jakplugg/Typhoon/README.md

# Typhoon
Clouds variant

BOM coming shortly!
