jakplugg/Typhoon/panel.pdf

## T Y P H O O N

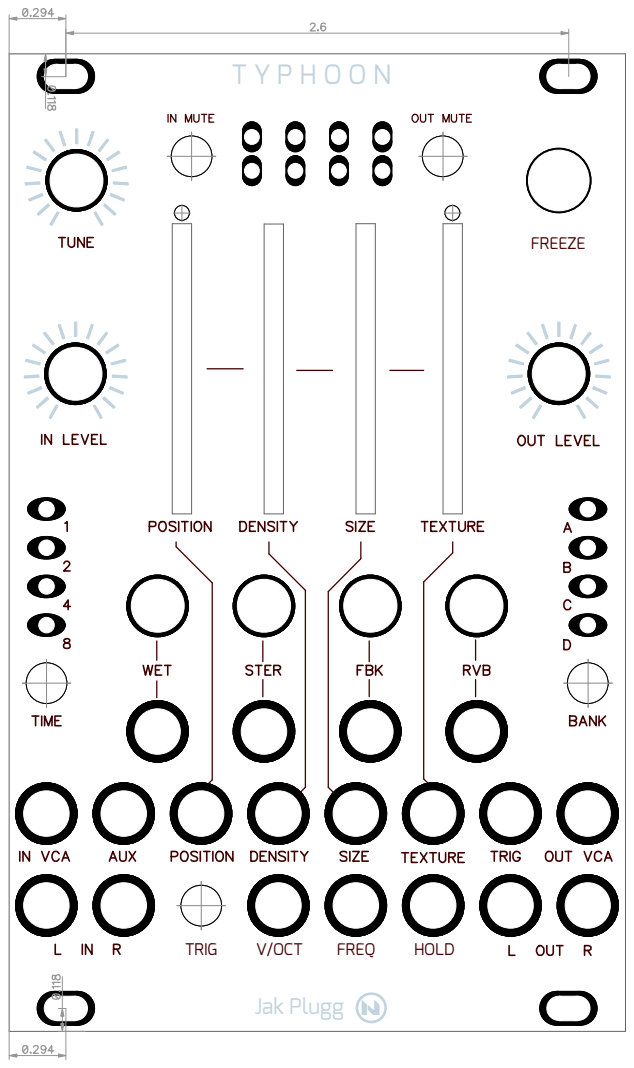
[picture p1: page 1]
Jak Plugg; TRIG; HOLD V/OCT; FREQ; FREEZE
