jakplugg/Typhoon/(list of files, drawings)

Other design files:
typhoon.dch
typhoon.dip
typhoon_panel.dip
