jakplugg/Typhoon/(threads)

Thread 1 (2019-11-26):

Pachinko

gregbabos, 2019-11-26:
Hi! I'm a hobbyist who would like to make my own Pachinko, but I can't seem to find the repository for the open-source code. I noticed it's for sale at Michigan Synth Works, so I imagine the code is open-sourced somewhere. Thanks for your time!

gregbabos, 2019-11-26:
My email address is gregbabos@gmail.com if that is preferred.

jakplugg, 2019-11-26:
Sorry it is taking a while, Now i am just waiting for panels to come
in for test fit.

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

gregbabos, 2019-11-26:
Ah, I thought it had been established that the panel fits since Michigan Synth Works has a picture of a finished Pachinko up

gregbabos, 2019-11-26:
Forgive my ignorance since I'm quite new to this, but are you affiliated with Michigan Synth Works? I'm wondering how they got the design if hasn't been open-sourced yet.

jakplugg, 2019-11-27:
He makes aluminum panels, this is for the pcbpanel. i'm just being
careful i don't release something which does not work properly!

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

jakplugg, 2019-11-27:
He does the test builds for my designs, if i did it myself things
would be much slower.

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

gregbabos, 2019-11-29:
Oh okay, thank you for the clarification and your work on open source!

Pipstapee, 2019-12-20:
Any word on the BOM, when is it due to be uploaded?

Thread 2 (2019-12-17):

Panel

TotalRefusal, 2019-12-17:
Hi! Not sure, but "TIME" and "BANK" seems to be wrong way, either on panel, or on pcb :) Cheers!

TotalRefusal, 2019-12-19:
>
>
> Hi! Not sure, but "TIME" and "BANK" seems to be wrong way, either on panel, or on pcb :) Cheers!

Took a look @schematics - seems the panel to be wrong way. BANK is left and TIME is right :)

dlavila, 2020-09-11:
why is this closed if the panel was not fixed?

Closed 2019-12-19.

Thread 3 (2019-12-20):

BOM and firmware?

Pipstapee, 2019-12-20:
Any news on the BOM for the Typhoon (Supercell/Monsoon/Clouds) pcb on the pusherman website. Also, firmware, would it be released as a HEX?

TotalRefusal, 2019-12-20:
>
>
> Any news on the BOM for the Typhoon (Supercell/Monsoon/Clouds) pcb on the pusherman website. Also, firmware, would it be released as a HEX?

Wow, Pusherman did the wrong panel design. Time & Bank is labeled wrong way, at least if you follow pcb & schematics.

Pipstapee, 2019-12-20:
> > Any news on the BOM for the Typhoon (Supercell/Monsoon/Clouds) pcb on the pusherman website. Also, firmware, would it be released as a HEX?
>
> Wow, Pusherman did the wrong panel design. Time & Bank is labeled wrong way, at least if you follow pcb & schematics.

It's a good job I've not ordered any yet. Woops...I'll let him know, thanks for pointing that out.

forestcaver, 2020-01-11:
You can build the fw yourself pretty easily - just follow the links in the microcell github to the superparasites fw. BOM can be exported from diptrace. Note that the export says it uses tle2172 (this is incorrect - it should be tlv2172 vssop package)

Tnunnery, 2020-02-12:
What is the value of the 30mm slider pots? Did I miss it somewhere?

jakplugg, 2020-02-12:
They are A10k, non detented. bourns PTL or compatible.

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

epijdemie, 2020-02-24:
@jakplugg what are the voltage ratings of the capacitors in use for Typhoon?

jakplugg, 2020-02-24:
Minimum 16v, but the higher the better.

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

epijdemie, 2020-03-03:
@jakplugg regarding firmware: can i upload the regular clouds via mutable vagrant and SWD (or even STLink util) so i have a bootloader and then user the superparasites.wav to upload the firmware? i can not get https://github.com/patrickdowling/superparasites compile in mutable's vagrant and i am too noob to configure it :/

forestcaver, 2020-03-03:
No - cant upload regular clouds fw to typhoon
To compile the superparasites - follow the instructions in the readme - see my comment above - you need to install a different arm toolchain into the mutable dev environment

epijdemie, 2020-03-03:
> No - cant upload regular clouds fw to typhoon
> To compile the superparasites - follow the instructions in the readme - see my comment above - you need to install a different arm toolchain into the mutable dev environment

damn, i am too stupid for linux stuff. i am using mutables vagrant on windows and literally copy/paste every command line from the mutable manual. is there maybe a vagrant around that has this toolchain installed? or a detailed tutorial for noobs like myself? :(

forestcaver, 2020-03-03:
I dont know if anyone has setup the vagrantbox scripts for this box. It wouldnt be hard to do...
I dont know of any detailed tutorials for setting up this exact configuration...
You could just upload a compiled bootloader and main fw hex with ST-Link utility....

epijdemie, 2020-03-03:
> I dont know if anyone has setup the vagrantbox scripts for this box. It wouldnt be hard to do...
> I dont know of any detailed tutorials for setting up this exact configuration...
> You could just upload a compiled bootloader and main fw hex with ST-Link utility....

i managed to compile the supercell.hex within the MI vagrant with the src and toolchain @patrickdowling listed in the superparasites github.. however it fails to compile the bootloader, and without it the upload command wount work and i guess uploading the hex without the bootloader wount do any good. and i also guess i cannot just take the clouds bootloader. so if anyone could link a pre-compiled supercell_bootloader_combo.hex i would be very thankful :)

TotalRefusal, 2020-03-03:
I took the Clouds bootloader & it works like a charm :)

epijdemie, 2020-03-03:
i just got the bootloader to compile by NOT taking the stmlib from superparasites, but MI original one. having a combo file now and very curios if its gonna work :) (build not finished yet)

TotalRefusal, 2020-03-03:
.... also use microcell.hex and guess what? It works like a charm :) Beside the slider leds (with opamps) it is pretty much the same hardware. Firmware does not care if there is a 10k pot or a 10k slider :)

frekkia, 2020-05-06:
What dielectrics do ceramic capacitors use?

jakplugg, 2020-05-07:
usually only C0G/NP0 capacitors are noted, default is X7R or X5R.

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

frekkia, 2020-05-07:
> usually only C0G/NP0 capacitors are noted, default is X7R or X5R.
> […](#)

I have seen that the white pushbutton uses a minimum voltage of 3.5v and I would like to change it with a green one, but it has a maximum voltage of 2.5v, is it okay?

jakplugg, 2020-05-08:
The circuit is designed with no LED resistor (because of the high
voltage drop of the white LED) theoretically there should be a 43 ohm
resistor in series if the LED only has 2.5 Voltage drop. it *MAY* be
OK, but if it is not, it will destroy that output on the STM.

i should add the resistors back in, they were removed in the microcell
which typhoon was adapted from, and i did not even notice.

On 5/7/20, frekkia <notifications@github.com> wrote:
>> usually only C0G/NP0 capacitors are noted, default is X7R or X5R.

>> […](#)

>

> I have seen that the white pushbutton uses a minimum voltage of 3.5v and I
> would like to change it with a green one, but it has a maximum voltage of
> 2.5v, is it okay?

>

> --

> You are receiving this because you were mentioned.

> Reply to this email directly or view it on GitHub:

> https://github.com/jakplugg/Typhoon/issues/3#issuecomment-625529699

frekkia, 2020-05-08:
In fact I was comparing the pcb of clouds and that of typhoon, clouds adds two 68 ohm resistors in series, I could cut the track and add them manually in typhoon, what do you say?

frekkia, 2020-05-08:
> The circuit is designed with no LED resistor (because of the high voltage drop of the white LED) theoretically there should be a 43 ohm resistor in series if the LED only has 2.5 Voltage drop. it *MAY* be OK, but if it is not, it will destroy that output on the STM. i should add the resistors back in, they were removed in the microcell which typhoon was adapted from, and i did not even notice.
> […](#)

In fact I was comparing the pcb of clouds and that of typhoon, clouds adds two 68 ohm resistors in series, I could cut the track and add them manually in typhoon, what do you say?

TotalRefusal, 2020-05-08:
I have a yellow LED running, with no problems so far :)

jakplugg, 2020-05-12:
no reason you can't cut the trace and add a resistor if you are comfortable doing so.

frekkia, 2020-05-24:
LM4040 is grade C okay?

Pipstapee, 2020-05-25:
LM4040 the grade C or B doesn't make a difference right?
You buying from Mouser, B or C will be ok.

Faye108, 2020-06-03:
@jakplugg What are suggested Ferrite beads for FB1 and FB2 ? I have some in stock that I had used for other Mutable clones. Can I use one of these? If so, which one?
Mouser no. 710-742792693
Mouser no. 710-742792642
Mouser no. 710-742792664

Another question regarding R28 and R36 : Both 49.9k placed between Aref-2.5 and U9 (SSI2146) : Mouser canceled it in my order. Can they be replaced by another value? A.e. 47k or something in the 51k range maybe?

thank you!

SatsumaAudio, 2020-07-27:
Is it definitely A10k? The original clouds uses B10k for these, or is there a reason to switch from linear to audio pots?

> They are A10k, non detented. bourns PTL or compatible.
> […](#)
> On 2/11/20, Tnunnery ***@***.***> wrote: What is the value of the 30mm slider pots? Did I miss it somewhere? -- You are receiving this because you are subscribed to this thread. Reply to this email directly or view it on GitHub: [#3 (comment)](https://github.com/jakplugg/Typhoon/issues/3#issuecomment-584953505)

chmanie, 2020-08-18:
If anyone still has problems with the firmware, here's how I compiled it:

https://chmanie.com/post/2020/08/11/flashing-superparasites-to-typhoon/

toneburst, 2020-10-01:
Is this the slider part?
PTL30-15G1-103B1

toneburst, 2020-10-01:
> I have a yellow LED running, with no problems so far :)

Is that yellow button LED still OK? How's the brightness?

I'm thinking of doing the same.

TotalRefusal, 2020-10-01:
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

Yep, still fine. Brightness is like perfect :)

Mesteves77, 2020-10-06:
Sourcing parts ahead of time, can anyone tell me what pots are these meant to be: POT_9MM_SNAP-IN__ (POT_9MM_SNAP-IN_)? TIA

toneburst, 2020-10-06:
10K linear, 6mm, like

https://www.thonk.co.uk/shop/alpha-9mm-pots-vertical-t18/
https://www.thonk.co.uk/shop/alpha-9mm-pots/
or
https://www.thonk.co.uk/shop/alpha-9mm-pots-dshaft/

Mesteves77, 2020-10-06:
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

Thanks man. i am familiar with the pots they do indeed feel great, plus a lot of knob choices on Round shafts and T18. One more thing, should any of them have center detent? Like the 4 pots for MIX, PAN, FBK, RVB, or even any of the other main control ones (pitch, In, Out)?
Looking forward to join this club, but Im yet merely a beginner coming into the intermediate level but thinking and buying ahead of time to minimize costs.

muziejus, 2021-02-22:
All, I've made a Mouser BOM. I'd love an extra few set of eyes on it:

https://www.mouser.com/ProjectManager/ProjectDetail.aspx?AccessID=13c2ca3d6c

Couple of notes from a non-engineer like me who's still built over a dozen diff modules:

* I kept the white LED switch
* I added the slightly pricier MCU, because it's the only one in stock. I think the only diff is it can handle running hotter.
* I split the pots into two categories. In, Out, and Pitch are 3 Alps pots. Mouser doesn't carry the Alpha pots, but I like these Alps pots and, most importantly, they have the skinny (1mm) mounting feet. I've used these pots on all my MI builds, though they do require designing panels w/ bigger (m9) holes.
* The other four pots are trimmer pots. AFAICT, Mouser doesn't sell the Song Huei tall trimmer pots.
* I also added a line for the switch caps.

muziejus, 2021-03-05:
I see I made mistakes on my own. My parts are coming in… once I confirm everything works (anyone have a spare WM8731SEDS/V?), I'll submit it as a PR to include a Mouserified BOM.

claesbert, 2021-03-14:
Thanks, @muziejus , would appreciate that!

mnefstead, 2021-09-05:
Hey @muziejus , have you had a chance to correct the mistakes you mentioned, or are there still some incorrect parts on that list?

Thread 4 (2020-01-09):

Typhoon hardware has bleeding into output from CV modulation channels

simodrws, 2020-01-09:
Dear Jak,

Thanks for the great design! Absolutely love the Typhoon. Here is a possible hardware bug I noticed:

If you put an audio rate signal (a square wave in my case)  into the following CV ports, you hear  it bleeding through to the outputs, even if the OUT VCA is turned down completely:

From loudest to quietest:
1. AUX in
2. OUT VCA
3. DENSITY
4. SIZE
5. TRIGGER
6. TEXTURE

The other CV ins (e.g. the different blend parameters) are unaffected.

This is not a problem when you use the clouds as a delay/reverb unit. But as soon as you start using the density parameter to increase the speed of the audio grains, you hear it in quiet parts when density is in the middle and the oscillator is modulating other parameters (e.g. AUX or TRIGGER).

This is especially bad because triggering the clouds with an audio rate signal is great for creating snare-roll like chordal pad beds & textures.

I have no idea about electronics but the guy who built it for me is TuneFish Modular, a (semi-) professional builder from Germany. He tested it with the MicroCell aswell and he experienced it too, although way quieter.

SuperCell was not available at the moment to test.

Now I wanted to ask:
Do you have the same problem aswell with your typhoon/Cell builds?

Is this a design problem or a matter of wrong assembly?

Regards from Germany,
Simo

TotalRefusal, 2020-01-10:
Hi there! Any response to that???

jakplugg, 2020-01-11:
Sorry you are having trouble! A bit of control bleedthrough It is kind of expected on the non-trimmable output VCA, and mine does it as well, But i can not hear any of the audio square wave (about +-4v) when i connect it to another CV input. I am not sure what is going on! my Typhoon is made by calsynth and has the Slider LEDs and drivers. The circuit is the same as microcell, apart from the layout and the LED drivers op amps.

jakplugg, 2020-01-11:
Are you hearing the whole square wave or just the transients? if you input a sine wave and you can not hear it, that might help narrow it down.

simodrws, 2020-01-11:
I am hearing with a sine aswell although way quieter. I will add a link to a video soon.

- bridging the LEDs (taking them out of the circuit), the sound disappears
- our suspicion is it's the conductor paths of the LEDs

simodrws, 2020-01-11:
here's the video:

https://drive.google.com/file/d/1vxSAUuN0tCY1LKijelGPFKnqjkUx-H_d/view?usp=sharing

forestcaver, 2020-01-15:
Tried this on mine (just finished it today). Copied what you did in your video. No bleed whatsoever on mine, checked it on a scope as well - nothing at all.

Just a thought - it may be worth checking what opamps are used to drive the leds - check you’ve used tlv272 and not tl072....

simodrws, 2020-01-16:
> Tried this on mine (just finished it today). Copied what you did in your video. No bleed whatsoever on mine, checked it on a scope as well - nothing at all.
>
> Just a thought - it may be worth checking what opamps are used to drive the leds - check you’ve used tlv272 and not tl072....

which filter beads (L1 & L2) did you guys use? @jakplugg  @forestcaver

We are waiting for the tlv272 to be delivered!

forestcaver, 2020-01-16:
Hah! I’m guessing it was tl072 then? :-)

Ferrite not too important - just helps reduce noise *from* this module to other modules. I used these (I think) mouser pn:

710-742792664

same as in rings and most of the mi stm32 builds...

simodrws, 2020-01-17:
yeah same here. lets see if the tlv272 make a difference!

simodrws, 2020-01-17:
hey, little update:

tried the tlv272, same thing.

the behaviour i showed you also happens when the module is disconnected from power.

signal bleed is about 25 milivolts in power.

when physically seperating the led drivers (desoldering and bridging), the bleed is gone.

really weird.

jakplugg, 2020-02-12:
what if you just pull the LEDs out of the faders, does it also go away?

Thread 5 (2020-02-11):

BOM says R98-R101 is 0402 1k resistor. But pads are 0603.

bengarland, 2020-02-11:
Seems like an error in the BOM and that 1k 0603 should go on R98, R99, R100, and R101.

Correct?

If so, then these RefDes should be merged with the other 1k of R3, R4, R5, R6, R39, etc...

Closed 2020-02-12.

Thread 8 (2020-02-17):

Typhoon & CV patching

TotalRefusal, 2020-02-17:
Hi there!
I noticed a strange behavoir when patching CV into Typhoon. All 4 slider led´s are flashing up in the moment when I plug the jack in. Is that normal (because of the AUX input feature) or did I miss something??
Cheers

TotalRefusal, 2020-02-17:
... this is the case with all CV inputs except V/Oct, Freeze and both VCA inputs

TotalRefusal, 2020-02-24:
Yeah, it is that AUX CV feature connected to the switches of the CV input jacks. Took a look @schematics. This clicks are also clearly audible of course, if patching cables are "hot"

Is there a workaround for that???

jakplugg, 2020-02-24:
Maybe the aux op amp or surrounding circuit is picking up the noise.
It was unaltered from the microcell (not sure if that was directly
copied from supercell) I will take a look at it.

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

TotalRefusal, 2020-02-24:
It´s a mechanical thing when plugging in the patching cable, I think. Happens only, when patching from a CV source into Typhoon. So when you plug in, you´are touching AUX CV bus for a fraction of a second, I suppose....

TotalRefusal, 2020-02-25:
Only solution I can see is patching from Typhoon to CV source and not vice versa. Or kick out that AUX CV bus feature... which makes no sense to me anyway :)

frekkia, 2020-06-16:
I have a problem with typhoon with the Spectral Clouds (Kammerl) mode, typhoon stops after a short while I use it what can it be?

Thread 10 (2020-05-05):

Flashing firmware with .wav file

TotalRefusal, 2020-05-05:
Does anybody know if flashing firmware with .wav files is an option for Typhoon??? Don´t make it to work with blinking Freeze on startup....

chmanie, 2020-08-18:
Yes, I did that successfully with the microcell and superparasites firmware. Press the freeze button while switching on power, then play the .wav file into an input. Make sure no other cables are patched. The freeze LED should blink frantically and after the wave is gone through the module restarts.

astrzepka, 2021-06-07:
It doesn't work for me either. I power up my system with Freeze button pressed, but module seems to power up as usual. Freeze blinks, but it also enters this mode if I hold it with module already powered up.
Playing .wav gives no result.

n0kulture, 2021-08-30:
Same problem here. I've tried to update/upgrade firmware but it doesn't work. The module enters in upgrade mode, but when I play the .wav file it didn't make any change, and when the file end, the module doesn't reboot. In original clouds when I send the .wav file the freeze button start to flash in different frequency.
So someone knows how to solve this problem?

dragosandriana, 2021-08-30:
> Same problem here. I've tried to update/upgrade firmware but it doesn't work. The module enters in upgrade mode, but when I play the .wav file it didn't make any change, and when the file end, the module doesn't reboot. In original clouds when I send the .wav file the freeze button start to flash in different frequency.
> So someone knows how to solve this problem?

Make sure you followed the procedure and that the wav file has uploaded until the end. Is very important that the module receives the whole wav file and doesn't stop responding while the file is playing. If it doesn't work, try with another player, cell phone worked for me. And different volumes.

n0kulture, 2021-08-30:
> Make sure you followed the procedure and that the wav file has uploaded until the end. Is very important that the module receives the whole wav file and doesn't stop responding while the file is playing. If it doesn't work, try with another player, cell phone worked for me. And different volumes.

No way, I've tried with my phone, my computer and differents players and volumes... but the module's behavior is like receive nothing even the VU leds were lighted... but the freeze LED flash all the time to same frequency. And yes, when the file end, the module continue to flash freeze led and no reboot.

dragosandriana, 2021-08-31:
> > Make sure you followed the procedure and that the wav file has uploaded until the end. Is very important that the module receives the whole wav file and doesn't stop responding while the file is playing. If it doesn't work, try with another player, cell phone worked for me. And different volumes.
>
> No way, I've tried with my phone, my computer and differents players and volumes... but the module's behavior is like receive nothing even the VU leds were lighted... but the freeze LED flash all the time to same frequency. And yes, when the file end, the module continue to flash freeze led and no reboot.

Try to write the hex clouds file with STLink to see if anything's wrong with the module.

astrzepka, 2021-09-06:
I tried every button I found on the module, it just doesn't go into bootloader mode so I can play .wav file to it.
I don't have JTAG programmer, found out that there's loaded wrong firmware to module which makes all CV inverted. I want to flash it with correct one but it just doesn't want to get into loader mode. UI behaves as I wasn't holding FREEZE button, after a sec it starts blinking indicating that sample playback is in reverse mode. Playing .wav file does nothing at any point of startup, button combo, etc.

Is there anything I can do without access to JTAG flasher?

dragosandriana, 2021-09-07:
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

You can't upload (play) a wav file on an empty or wrongly written firmware. First you have to upload the official hex clouds fw.
Then power the module with "freeze" button pressed. After this, the "freeze" LED should blink. If it doesn't blink, re-write the original hex fw using jtag pins, with ST-Link v2 (or some similar device). There is no way around this. On the other hand, if you're in DIY and want to make some Mutable Instruments modules without having ST-Link programmer, you'd better forget about it. Is a cheap and essential device.

Thread 11 (2020-10-01):

LED-Button

acik1, 2020-10-01:
What kind of LED-Button should i get? A mouser link would be appreciated.

RiccardoRics, 2020-10-28:
Check Mutable Clouds BOM, it should be the same: https://github.com/pichenettes/eurorack/tree/master/clouds/hardware_design

E-switch LP4OA1PBCTG

pjbulls, 2021-01-01:
Keep in mind [this comment](https://github.com/jakplugg/Typhoon/issues/3#issuecomment-625804592) in #3: there's no current-limiting resistor in the design right now so anything other than a LED with a high forward voltage drop may damage the MCU. An easy fix would be to connect a small resistor (50-ish ohms) in series with one of the switch legs.

Thread 13 (2021-01-01):

Slider LED drivers

pjbulls, 2021-01-01:
I'm trying to understand the choice in the op-amps used for the slider LED drivers (TLV2172)? It seems like a much cheaper one could be used, no need for rail-to-rail output or high slew rate.

Furthermore, there's just the LED in the feedback path, but nothing can go the other way. Could this not damage the LED if you apply a high (negative) CV? Might it be safer to connect a diode of opposite polarity in parallel with the slider LEDs?

jakplugg, 2021-01-02:
You can use TL072, that is a mistake, sorry! as for damaging the LED, i have not heard of that happening, mutable instruments uses the LED in the op amp feedback as well. You can also put bipolar red/green LEDs in the sliders and they indicate polarity with color.

pjbulls, 2021-01-02:
Great, thanks for confirming! Bipolar slider LEDs sound lovely but I've never been able to find any 😄

jakplugg, 2021-01-03:
Just a note, You can use round 3mm LEDs on the sliders if they don't have a flange.

Closed 2021-01-02.

Thread 14 (2024-02-25):

CV's for fader inverted?

sablintechno, 2024-02-25:
hello,

i have noticed that the CV inputs of the faders are rotated.

if you apply a positive voltage to the cv, the fade "moves" down. I would have assumed that the fade would then move upwards.

Am I right?

sablintechno, 2024-02-26:
It is not an bug, but a feature. see on the Grayscale manual under "Expanded Modulation Options"

"Each of the nine granular processing parameters has its own CV input with an inverting attenuator (attenuverter) to set the level and polarity of external CVs."

Closed 2024-02-26.
