jakplugg/Typhoon/(commit log)

2019-11-21 added schematic
    [typhoon.dch]
2020-01-05 fixed incorrect panel text
    [typhoon_BOM.csv, typhoon_centroid.csv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]
2020-02-12 changed BOM
    some resistors were incorrectly marked as 0402
    [typhoon_BOM.csv]
2020-02-12 update BOM again
    [typhoon_BOM.csv]
